mzaprudin/DialScroll/hardware/cad/DialScroll.step

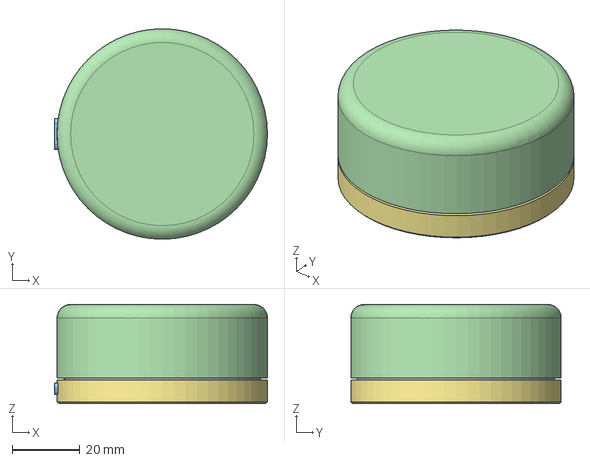
[picture p3: CAD file, 2026-11-09]
hardware/cad/DialScroll.step
62.8 x 62.0 x 29.2 mm
