mzaprudin/DialScroll/(list of files, cad)

Other CAD files:
hardware/cad/DialScroll.f3d
