mzaprudin/DialScroll/(commit log)

2026-08-11 Document wireless scroll architecture
2026-08-14 Add switchable MT6701 ADC and I2C paths
2026-08-14 Add LED heartbeat with delayed work
2026-08-14 Add EMA filtering for I2C encoder angles
2026-08-15 Improve battery ADC diagnostics
2026-08-16 Fix heartbeat LED polarity
2026-08-16 Shorten heartbeat LED pulse cycle
    [heartbeat.c]
2026-08-16 Add AS5600 encoder autodetection
2026-11-08 test: align filter expectation with angle scale
2026-11-09 [UPD] Add enclosure CAD and animation [skip ci]
    [DialScroll.f3d, DialScroll.step]
2026-11-09 [UPD] Loop enclosure animation smoothly [skip ci]
